BlackIoT/Martinica/node-red/Client/MARTINICA_DEMO/README.md

MARTINICA_DEMO
==============

Demo for Martinica Board

### About

This is your project's README.md file. It helps users understand what your
project does, how to use it and anything else they may need to know.
