BlackIoT/Martinica/Schematics/220321_Martinica_A0_BOM.xlsx

Q.ty | Part Reference | Cod BLK | Description | Mfr | Mfr Part Number | Digi-Key | Mouser
1 | C1 | BLK-000066 | CAP CER 4700PF 50V 10% X7R 0402 | Yageo | CC0402KRX7R9BB472 | 311-1418-1-ND
26 | C2, C9, C10, C12, C13, C14, C18, C19, C20, C21, C22, C23, C25, C26, C28, C31, C32, C33, C45, C46, C47, C48, C49, C50, C54, C56 | BLK-000235 | CAP CER 10PF 50V 5% NP0 0402 | Murata | GRM1555C1H100JA01 | 490-5921-1-ND
2 | C3, C4 | BLK-000065 | CAP CER 20PF 50V 5% NP0 0402 | Yageo | CC0402JRNPO9BN200 | 311-1417-1-ND | 80-CBR04C200J5G
4 | C5, C6, C7, C58 | BLK-000257 | CAP CER 10NF 50V 10% X7R 0402 | Samsung | CL05B103KB5NNNC | 1276-1028-1-ND
11 | C8, C35, C36, C37, C38, C39, C41, C42, C43, C44, C51 | BLK-000258 | CAP CER 100NF 50V 10% X5R 0402 | Murata | GRM155R61H104KE14D | 490-10697-1-ND
2 | C11, C52 | BLK-000073 | CAP CER 1UF 25V 10% X5R 0402 | TDK | C1005X5R1E105K050BE | 445-175215-1-ND
5 | C24, C27, C30, C34, C55 | BLK-000113 | CAP CER 4.7UF 10V 10% X5R 0402 | Samsung | CL05A475KP5NRNC | 1276-1480-1-ND
1 | C29 | BLK-000052 | CAP CER 1NF 50V 10% X7R 0402 | AVX | 04025C102KAT2A | 478-1101-1-ND
3 | C40, C53, C57 | BLK-000255 | CAP CER 10UF 10V 20% X5R 0402 | Samsung | CL05A106MP5NUNC | 1276-1450-1-ND
5 | D1, D2, D3, D4, D5 | BLK-000244 | DIODE SCHOTTKY 30V 800MA USC | Toshiba | CUS08F30,H3F | CUS08F30H3FCT-ND
2 | F1, F2 | BLK-000198 | FUSE PTC RESET 500MA SMD 0603 | Bourns Inc | MF-FSMF050X-2 | MF-FSMF050X-2CT-ND | 652-MFFSMF050X-2
1 | J1 | BLK-000261 | CONN RCPT USB MICRO B R/A SMT | Wurth | 629105136821 | 732-3155-1-ND
1 | J2 | BLK-000260 | CONN 1.27 2X5 SMD SHRD | CnC Tech | 3220-10-0300-00 | 1175-1629-ND
1 | J6 | BLK-000263 | CONN HEADER SMD R/A 3POS 2MM | JST | S3B-PH-SM4-TB(LF)(SN) | 455-1750-1-ND
2 | L1, L2 | BLK-000273 | FERRITE BEAD 120 OHM 0603 1LN | Murata | BLM18AG121SN1D | 490-1011-1-ND
1 | LD1 | BLK-000058 | LED RED 0603 SMD | Wurth | 150060RS75000 | 732-4978-1-ND
1 | LD2 |  | 2121 PLCC4 TRICOLOR | Broadcom | ASMB-LTC2-0A335 | 516-4290-1-ND | 630-ASMB-LTC2-0A335
1 | LD3 | BLK-000059 | LED BRIGHT GREEN 0603 SMD | Wurth | 150060VS75000 | 732-4980-1-ND
1 | LD4 | BLK-000274 | LED GREEN/YELLOW SMD | Wurth | 150066YV54050 | 732-150066YV54050TR-ND
1 | M1 |  | RX TXRX MOD WIFI TRACE ANT SMD | Microchip | ATWINC1500-MR210PB | ATWINC1500-MR210PB-ND
2 | PB1, PB2 | BLK-000239 | SWITCH TACTILE SPST-NO 0.05A 12V PEG | C&K | PTS820 J20KP SMTR LFS | CKN10895CT-ND | 611-PTS820J20KPSMTR
2 | Q1, Q2 |  | SMALL LOW ON RESISTANCE MOSFET | Toshiba | SSM3J358R,LF | SSM3J358RLFCT-ND
8 | R1, R19, R20, R26, R27, R28, R30, R32 | BLK-000276 | RES SMD 1M OHM 1% 1/16W 0402 | Yageo | RC0402FR-071ML | 311-1.00MLRCT-ND
3 | R2, R6, R8 | BLK-000277 | RES SMD 330 OHM 1% 1/16W 0402 | Yageo | RC0402FR-07330RL | 311-330LRCT-ND
3 | R3, R4, R43 | BLK-000100 | RES SMD 1K OHM 1% 1/16W 0402 | Yageo | AC0402FR-071KL | 311-1KLBCT-ND
3 | R5, R7, R47 | BLK-000169 | RES SMD 10K OHM 1% 1/16W 0402 | Yageo | RMCF0402FT10K0 | RMCF0402FT10K0CT-ND
1 | R9 | BLK-000283 | RES 316K OHM 1% 1/16W 0402 | Yageo | RC0402FR-07316KL | YAG3113CT-ND
1 | R10 | BLK-000284 | RES 115K OHM 1% 1/16W 0402 | Yageo | RC0402FR-07115KL | YAG2956CT-ND
24 | R11, R12, R13, R14, R15, R16, R17, R18, R22, R23, R24, R35, R36, R37, R38, R39, R40, R41, R49, R52, R53, R57, R58, R62 | BLK-000159 | RES SMD 0 OHM JUMPER 1/16W 0402 | Yageo | RC0402JR-070RP | YAG1279CT-ND
1 | R25 |  | RES 162 OHM 1% 1/10W 0603 | Yageo | RC0603FR-07162RL | 311-162HRCT-ND
4 | R33, R34, R59, R60 | BLK-000166 | RES SMD 4.7K OHM 1% 1/10W 0603 | Yageo | RC0603FR-074K7L | 311-4.70KHRCT-ND
1 | R44 | BLK-000281 | RES SMD 220 OHM 1% 1/16W 0402 | Yageo | RC0402FR-07220RL | 311-220LRCT-ND
2 | R45, R61 | BLK-000063 | RES SMD 100K OHM 1% 1/16W 0402 | Yageo | RC0402FR-07100KL | 311-100KLRCT-ND
1 | R46 | BLK-000153 | RES SMD 680 OHM 1% 1/16W 0402 | Delta/Cyntec | PFR05S-681-FNH | 2037-PFR05S-681-FNHCT-ND
1 | R48 | BLK-000282 | RES SMD 2.87K OHM 1% 1/10W 0603 | Yageo | RC0603FR-072K87L | 311-2.87KHRCT-ND
1 | R51 | BLK-000162 | RES SMD 10K OHM 1% 1/10W 0603 | Yageo | RC0603FR-0710KL | 311-10.0KHRCT-ND
2 | R54, R55 |  | RES SMD 0 OHM JUMPER 1/10W 0603 | Yageo | RC0603JR-070RL | 311-0.0GRCT-ND | 603-RC0603JR-070RL
1 | R63 |  | RES 422 OHM 1% 1/10W 0603 | Yageo | RC0603FR-07422RL | 311-422HRCT-ND
1 | R64 |  | RES 28 OHM 1% 1/10W 0603 | Yageo | RC0603FR-0728RL | 311-28.0HRCT-ND
3 | TVS1, TVS2, TVS3 | BLK-000286 | TVS DIODE 5.5VWM 12VC DFN1006-2 | Diodes | D5V0F1U2LPQ-7B | 31-D5V0F1U2LPQ-7BCT-ND
1 | U1 | BLK-000265 | IC MCU 32BIT 256KB FLASH 64QFN | Microchip | ATSAMD21J18A-MU | ATSAMD21J18A-MU-ND
1 | U2 |  | IC FLASH 64MBIT SPI/QUAD 8WDFN | Microchip | SST26VF064B-104V/MF | SST26VF064B-104V/MF-ND
1 | U3 | BLK-000266 | Humidity, Pressure, Temperature, VOC Sensor | Bosch | BME688 | 828-BME688CT-ND
1 | U4 |  | IC AUTHENTICATION CHIP 8UDFN | Microchip | ATECC608B-MAHDA-S | 150-ATECC608B-MAHDA-SCT-ND
1 | U5 |  | IC RFID TRANSP 64Kb 13.56MHZ 8UFDFPN | STM | M24SR64-YMC6T/2 | 497-14346-1-ND
1 | U6 |  | IC REG LINEAR 3.3V 500MA 8DFN | Microchip | MCP1725T-3302E/MC | MCP1725T-3302E/MCCT-ND | 579-MCP1725T-3302EMC
1 | U7 |  | IC LI-ION/LI-POLY CTRLR 10DFN | Microchip | MCP73833T-FCI/MF | MCP73833T-FCI/MFCT-ND
1 | Y1 | BLK-000262 | CRYSTAL 32.768KHZ ±20PPM 12.5PF 70KOHM | Abracom | ABS07-32.768KHZ-T | 535-9542-1-ND | 815-ABS07-32.768KHZT
