BlackIoT/Martinica/Schematics/220321_Martinica_A0.pdf

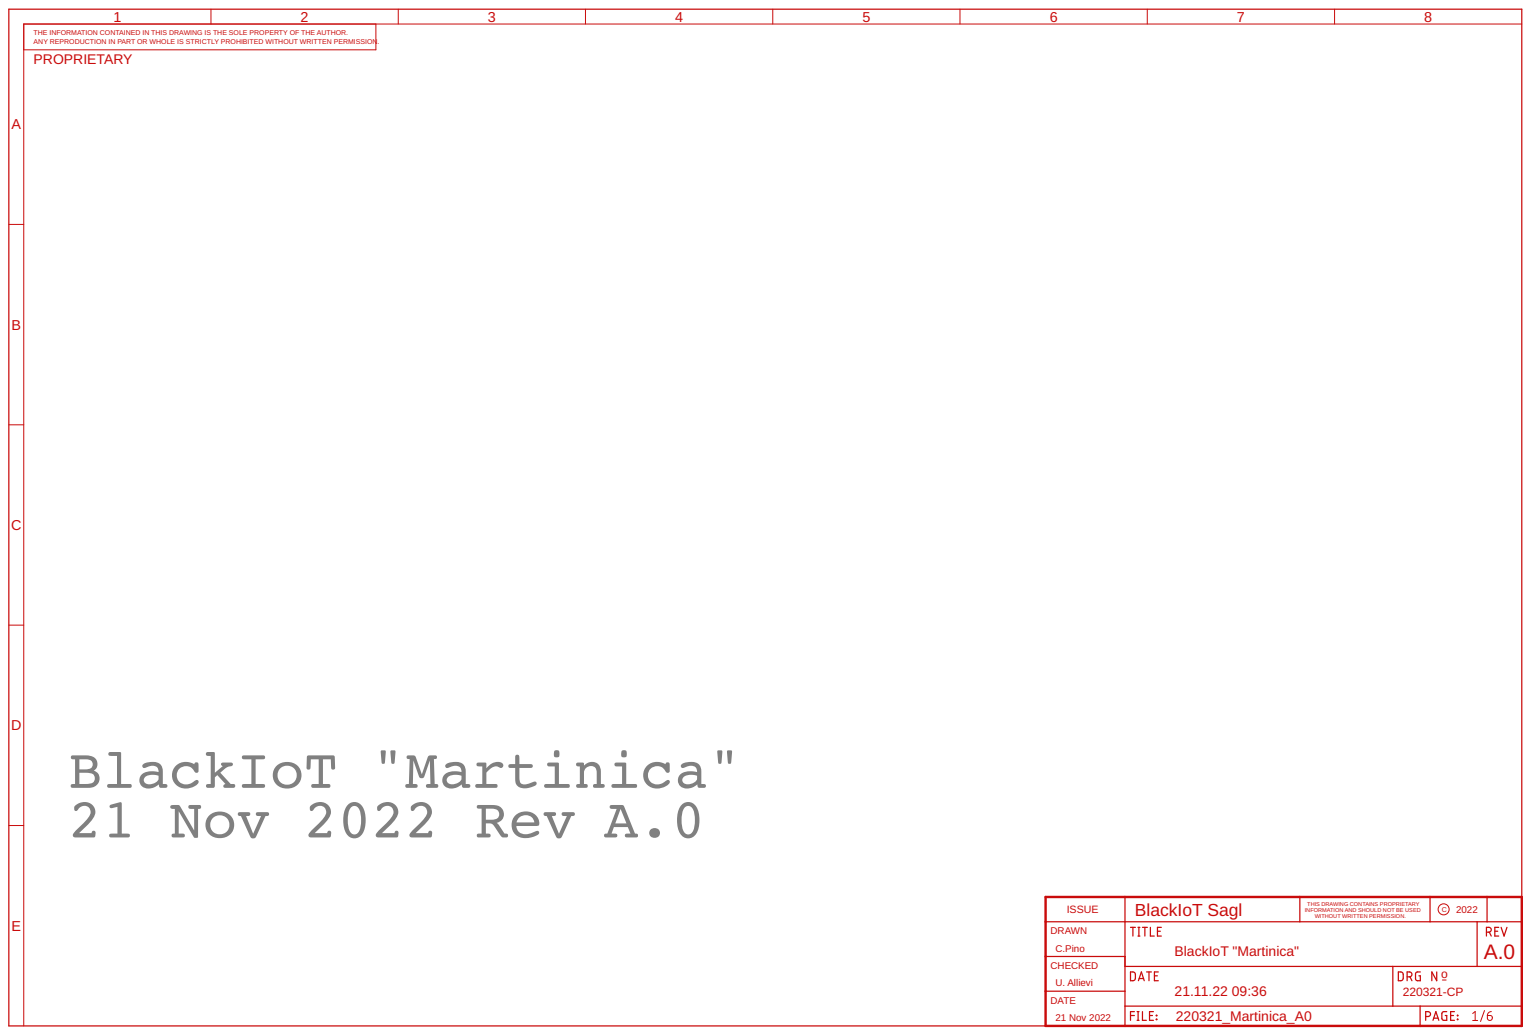
[picture p1: page 1]

THE INFORMATION CONTAINED IN THIS DRAWING IS THE SOLE PROPERTY OF THE AUTHOR. ANY REPRODUCTION IN PART OR WHOLE IS STRICTLY PROHIBITED WITHOUT WRITTEN PERMISSION.

ISSUE | BlackIoT Sagl | THIS DRAWING CONTAINS PROPRIETARY INFORMATION AND SHOULD NOT BE USED WITHOUT WRITTEN PERMISSION. | C 2022

DRAWN | BlackIoT "Martinica" | A.0

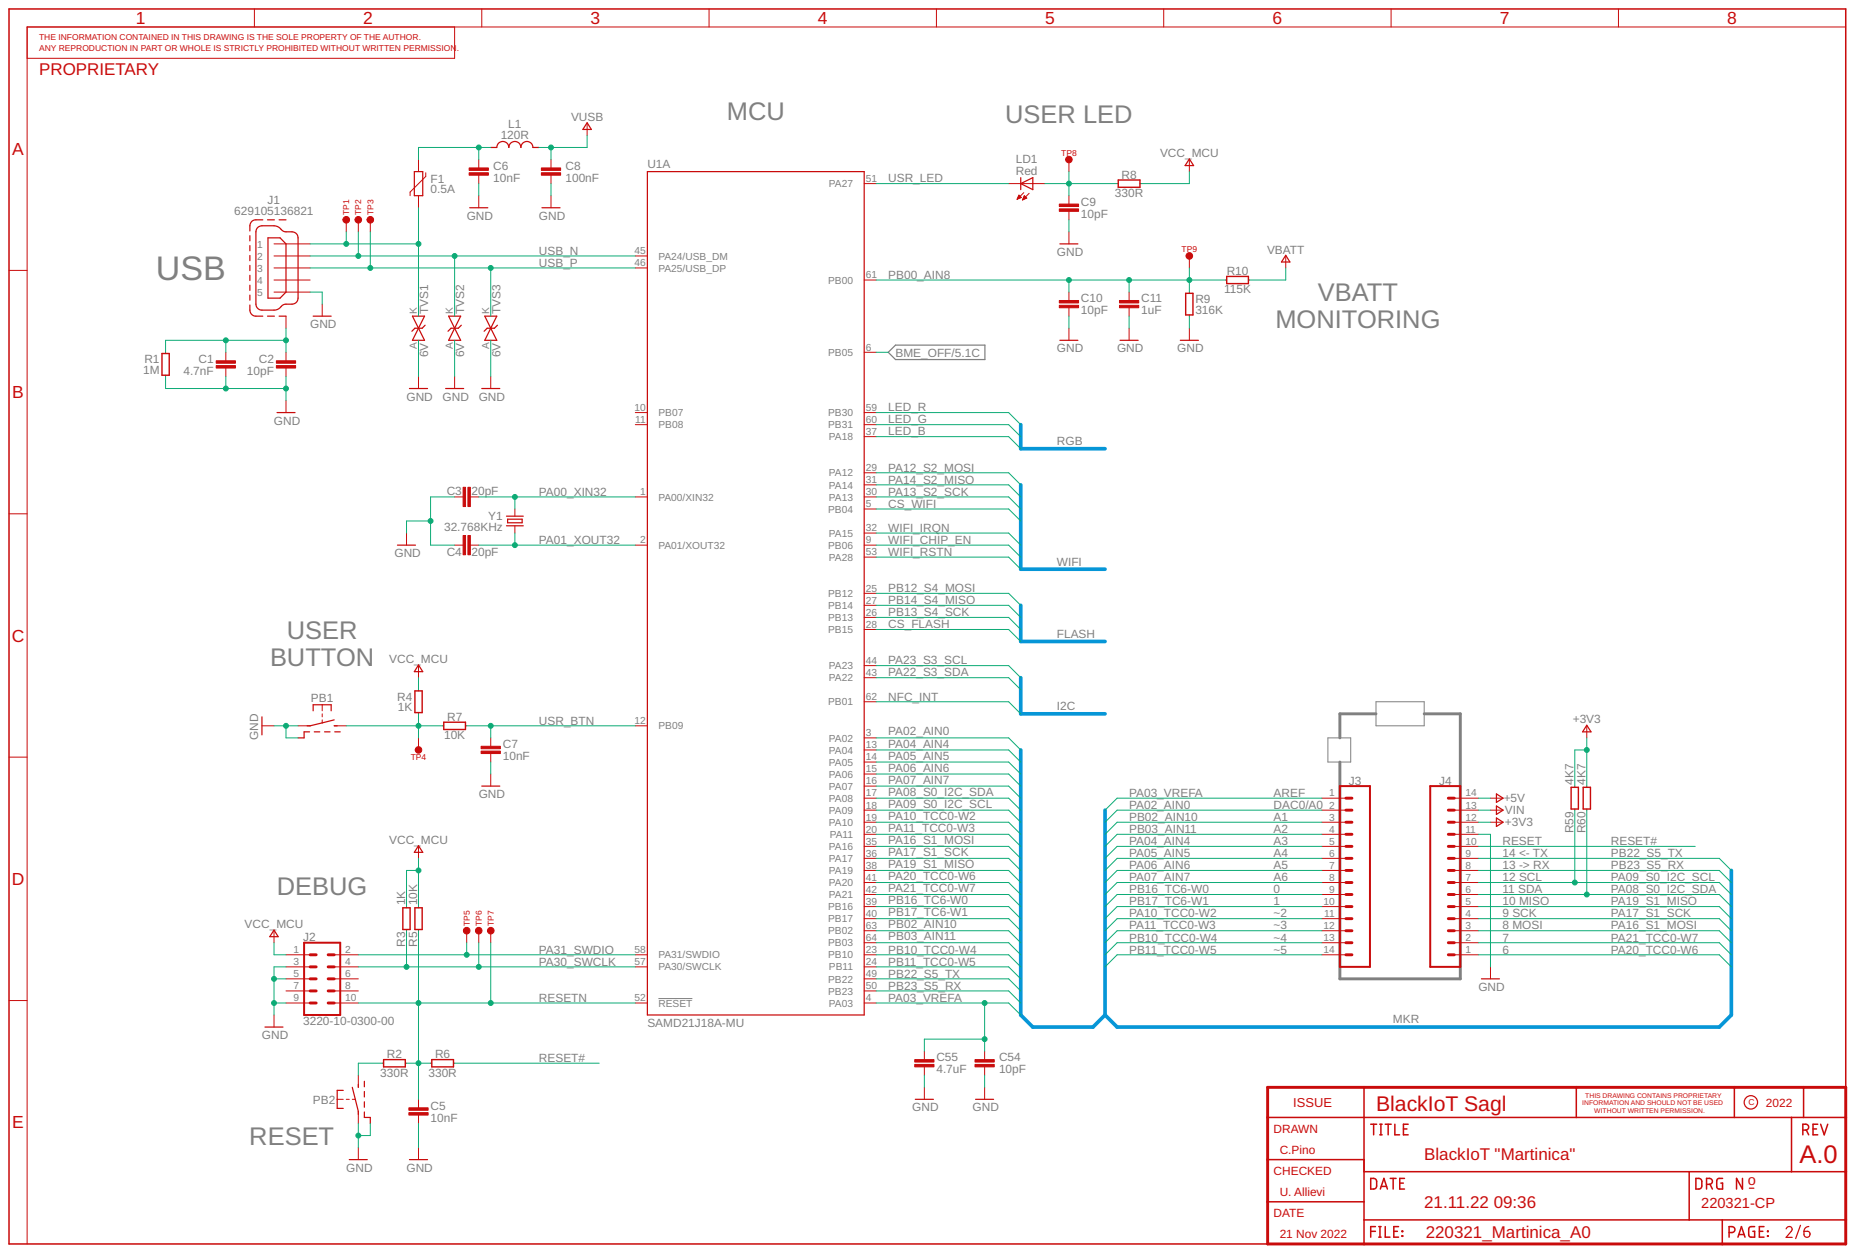
[picture p2: page 2]

PA30_SWCLK

RESETN 52

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

DRAWN | BlackIoT "Martinica" | A.0

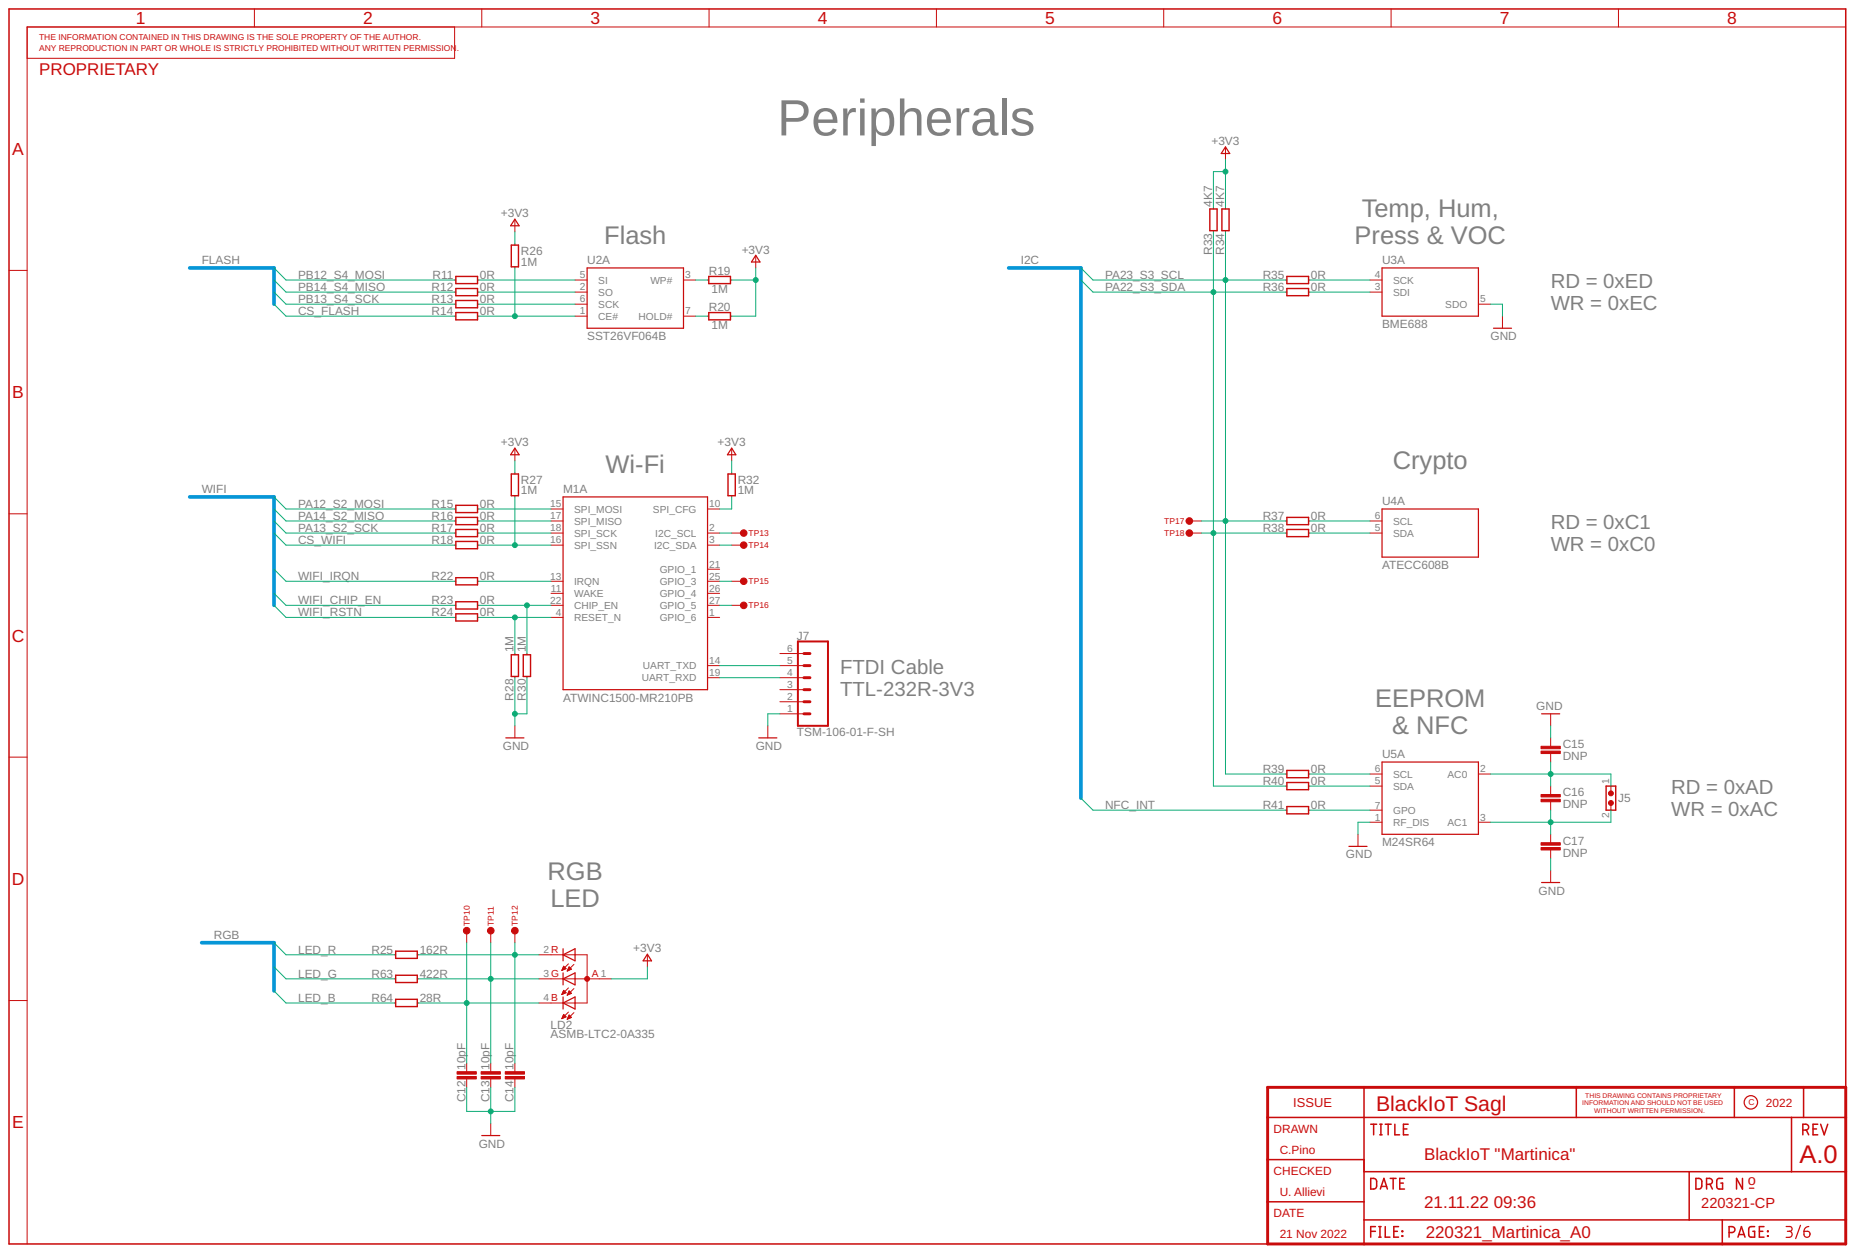
[picture p3: page 3]

Temp, Hum, Press & VOC

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

DRAWN | BlackIoT "Martinica" | A.0

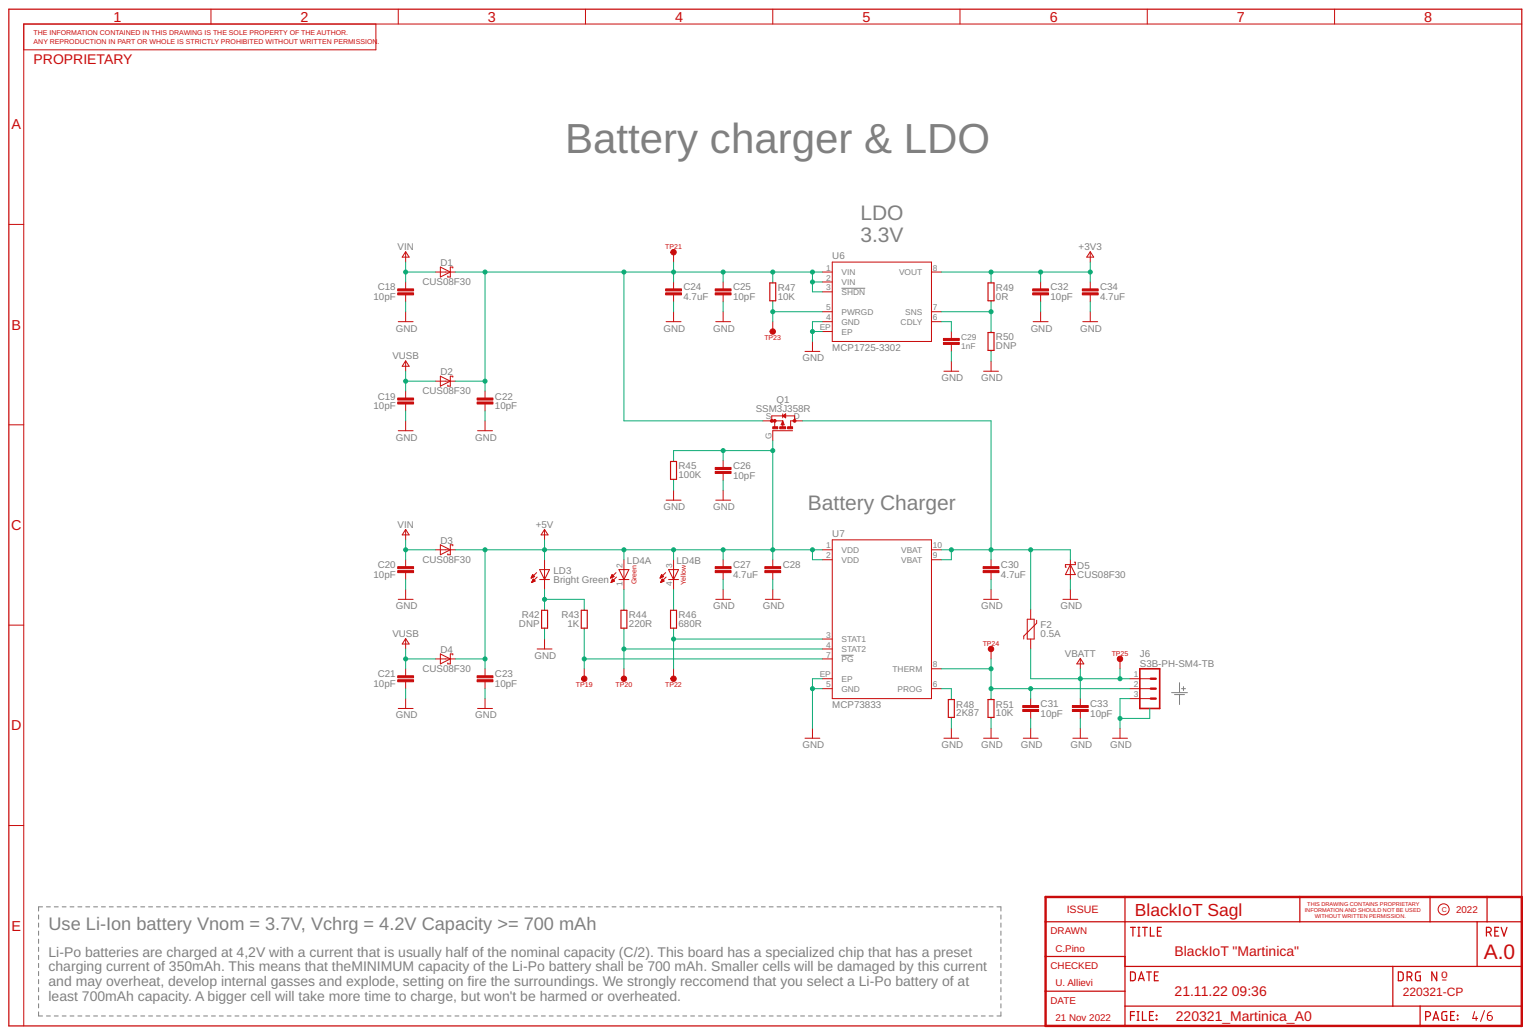
[picture p4: page 4]
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

least 700mAh capacity. A bigger cell will take more time to charge, but won't be harmed or overheated. Use Li-Ion battery Vnom = 3.7V, Vchrg = 4.2V Capacity >= 700 mAh
Li-Po batteries are charged at 4,2V with a current that is usually half of the nominal capacity (C/2). This board has a specialized chip that has a preset
charging current of 350mAh. This means that theMINIMUM capacity of the Li-Po battery shall be 700 mAh. Smaller cells will be damaged by this current
and may overheat, develop internal gasses and explode, setting on fire the surroundings. We strongly reccomend that you select a Li-Po battery of at

DRAWN | BlackIoT "Martinica" | A.0

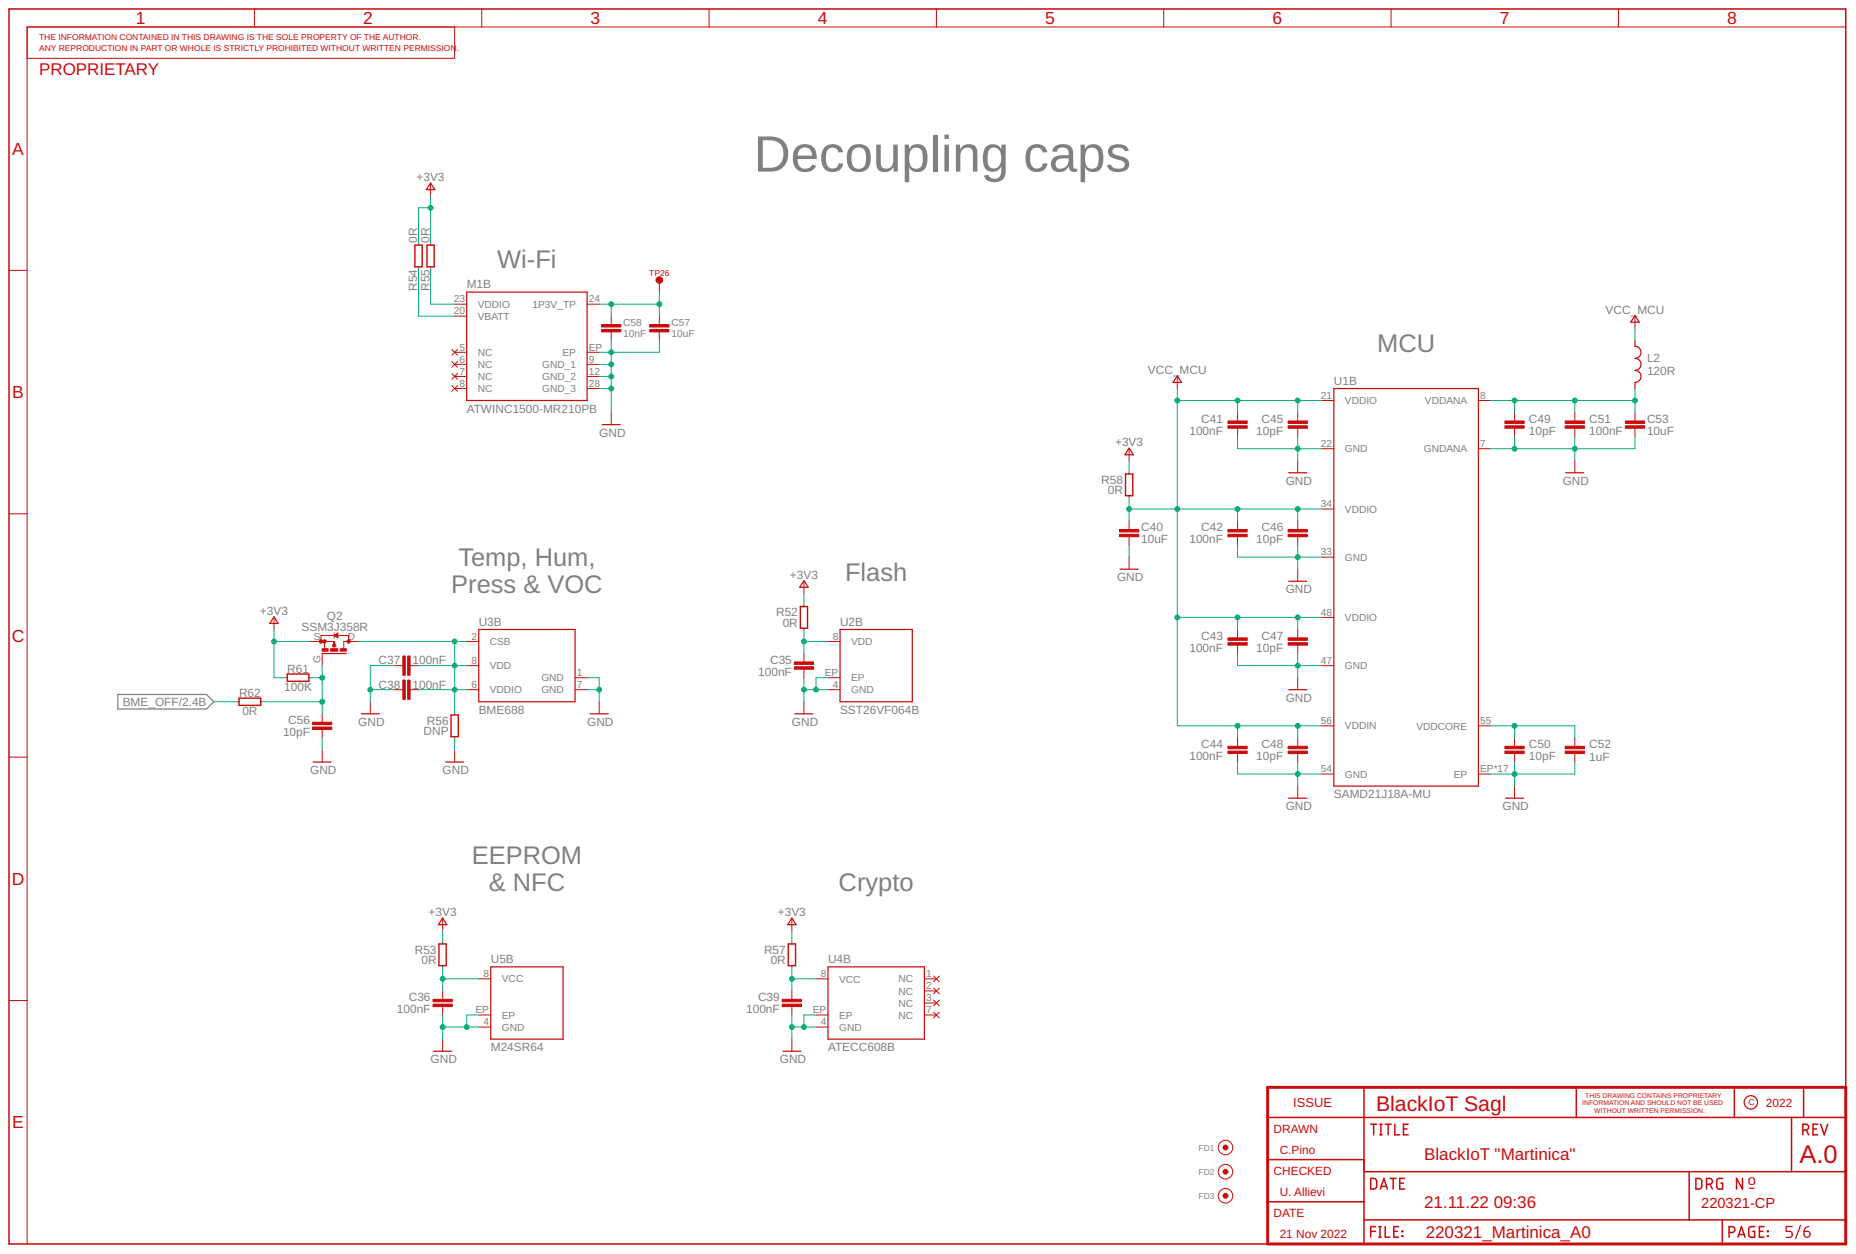
[picture p5: page 5]

Flash Temp, Hum, Press & VOC

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

DRAWN | BlackIoT "Martinica" | A.0

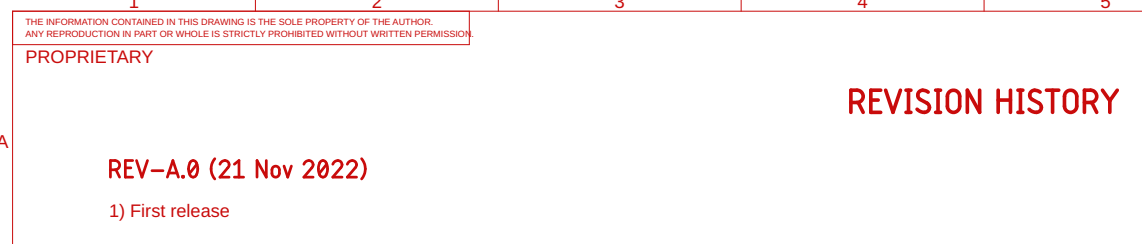
[picture p6: page 6]
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

DRAWN | BlackIoT "Martinica" | A.0
