BlackIoT/Martinica/Schematics/220321_Martinica_A0_ASSY_Bottom.pdf

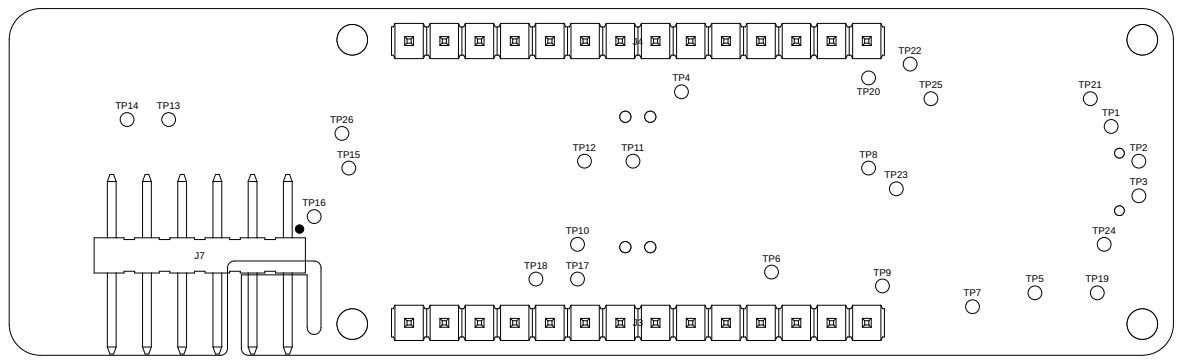
[picture p7: page 1]
