BlackIoT/Martinica/Schematics/220321_Martinica_A0_ASSY_Top.pdf

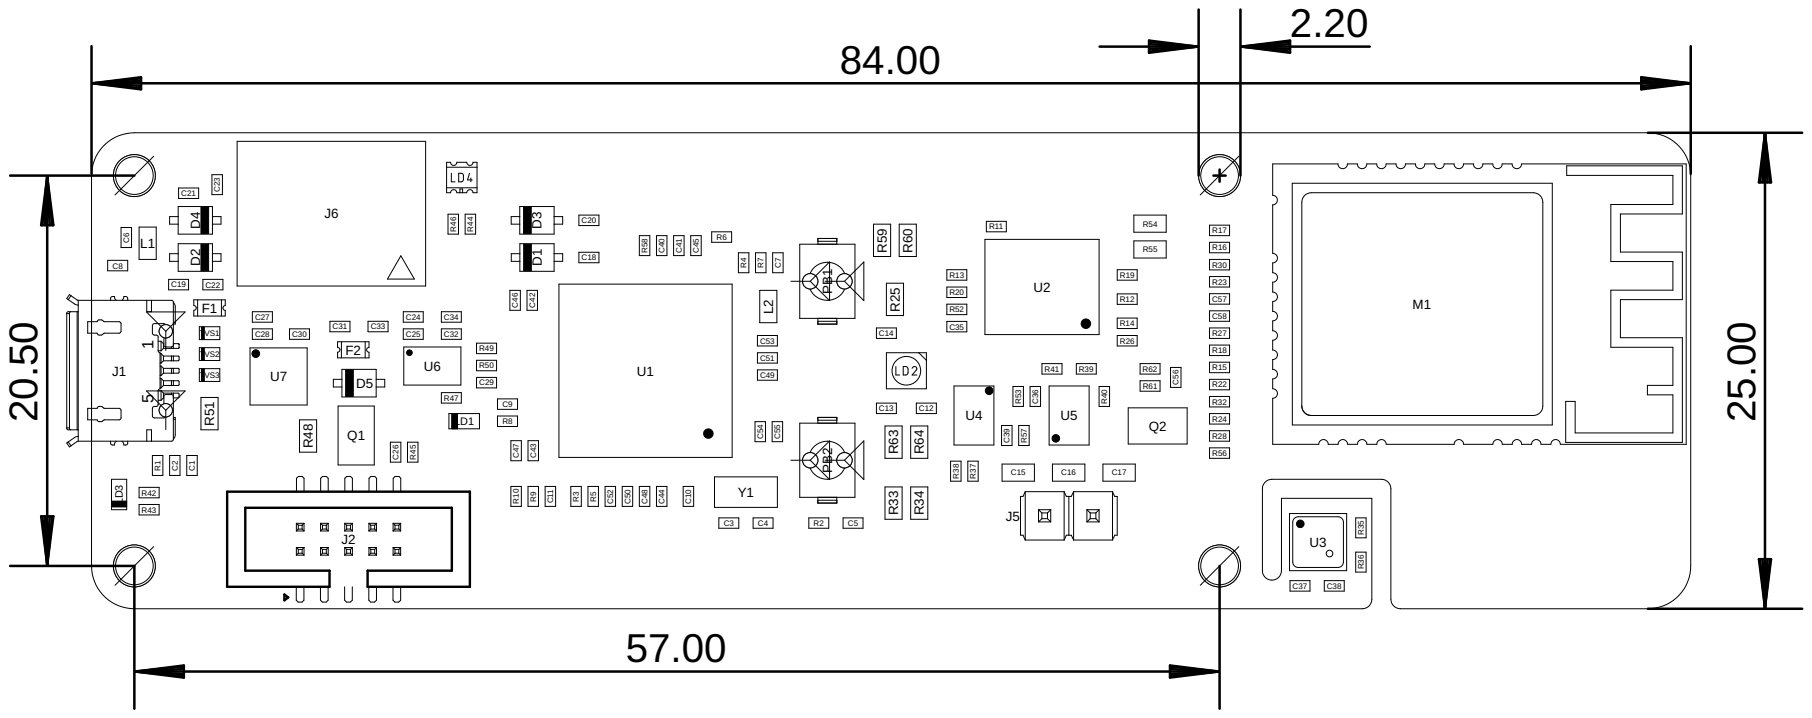
[picture p8: page 1]
