BlackIoT/Martinica/hardware/BlackIoT/samd/variants/martinica/variant.cpp

/*
  Copyright (c) 2014-2015 Arduino LLC.  All right reserved.

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
  You should have received a copy of the GNU Lesser General Public
  License along with this library; if not, write to the Free Software
  Foundation, Inc., 51 Franklin St, Fifth Floor, Boston, MA  02110-1301  USA
*/

#include "variant.h"

const PinDescription g_APinDescription[] = {

/*
 +------------+------------------+--------+-----------------+--------+-----------------------+---------+---------+--------+--------+----------+----------+
 | Pin number |  MKR  Board pin  |  PIN   | Notes           | Peri.A |     Peripheral B      | Perip.C | Perip.D | Peri.E | Peri.F | Periph.G | Periph.H |
 |            |                  |        |                 |   EIC  | ADC |  AC | PTC | DAC | SERCOMx | SERCOMx |  TCCx  |  TCCx  |    COM   | AC/GLCK  |
 |            |                  |        |                 |(EXTINT)|(AIN)|(AIN)|     |     | (x/PAD) | (x/PAD) | (x/WO) | (x/WO) |          |          |
 +------------+------------------+--------+-----------------+--------+-----+-----+-----+-----+---------+---------+--------+--------+----------+----------+
 | 00         | D0               |  PB16  |                 |  *00   |     |     | X04 |     |   5/00  |         |* TC6/0 | TCC0/4 | I2S/SD1  | GCLK_IO2 | // Martinica
 | 01         | D1               |  PB17  |                 |  *01   |     |     | X05 |     |   5/01  |         |* TC6/1 | TCC0/5 | I2S/MCK0 | GCLK_IO3 | // Martinica
 | 02         | D2               |  PA10  |                 |   10   | *18 |     | X02 |     |   0/02  |   2/02  |*TCC1/0 | TCC0/2 | I2S/SCK0 | GCLK_IO4 |
 | 03         | D3               |  PA11  |                 |   11   | *19 |     | X03 |     |   0/03  |   2/03  |*TCC1/1 | TCC0/3 | I2S/FS0  | GCLK_IO5 |
 | 04         | D4               |  PB10  |                 |  *10   |     |     |     |     |         |   4/02  |* TC5/0 | TCC0/4 | I2S/MCK1 | GCLK_IO4 |
 | 05         | D5               |  PB11  |                 |  *11   |     |     |     |     |         |   4/03  |* TC5/1 | TCC0/5 | I2S/SCK1 | GCLK_IO5 |
 | 06         | D6               |  PA20  |                 |  *04   |     |     | X08 |     |   5/02  |   3/02  |  TC7/0 |*TCC0/6 | I2S/SCK0 | GCLK_IO4 |
 | 07         | D7               |  PA21  |                 |  *05   |     |     | X09 |     |   5/03  |   3/03  |  TC7/1 |*TCC0/7 | I2S/FS0  | GCLK_IO5 |
 +------------+------------------+--------+-----------------+--------+-----+-----+-----+-----+---------+---------+--------+--------+----------+----------+
 */
  { PORTB, 16, PIO_DIGITAL, (PIN_ATTR_DIGITAL|PIN_ATTR_PWM|PIN_ATTR_TIMER    ), No_ADC_Channel, PWM6_CH0,   TC6_CH0,      EXTERNAL_INT_0    },
  { PORTB, 17, PIO_DIGITAL, (PIN_ATTR_DIGITAL|PIN_ATTR_PWM|PIN_ATTR_TIMER    ), No_ADC_Channel, PWM6_CH1,   TC6_CH1,      EXTERNAL_INT_1    },
  { PORTA, 10, PIO_DIGITAL, (PIN_ATTR_DIGITAL|PIN_ATTR_PWM|PIN_ATTR_TIMER    ), ADC_Channel18,  PWM1_CH0,   TCC1_CH0,     EXTERNAL_INT_NONE },
  { PORTA, 11, PIO_DIGITAL, (PIN_ATTR_DIGITAL|PIN_ATTR_PWM|PIN_ATTR_TIMER    ), ADC_Channel19,  PWM1_CH1,   TCC1_CH1,     EXTERNAL_INT_NONE },
  { PORTB, 10, PIO_DIGITAL, (PIN_ATTR_DIGITAL|PIN_ATTR_PWM|PIN_ATTR_TIMER    ), No_ADC_Channel, PWM5_CH0,   TC5_CH0,      EXTERNAL_INT_10   },
  { PORTB, 11, PIO_DIGITAL, (PIN_ATTR_DIGITAL|PIN_ATTR_PWM|PIN_ATTR_TIMER    ), No_ADC_Channel, PWM5_CH1,   TC5_CH1,      EXTERNAL_INT_11   },
  { PORTA, 20, PIO_DIGITAL, (PIN_ATTR_DIGITAL|PIN_ATTR_PWM|PIN_ATTR_TIMER_ALT), No_ADC_Channel, PWM0_CH6,   TCC0_CH6,     EXTERNAL_INT_4    },
  { PORTA, 21, PIO_DIGITAL, (PIN_ATTR_DIGITAL|PIN_ATTR_PWM|PIN_ATTR_TIMER_ALT), No_ADC_Channel, PWM0_CH7,   TCC0_CH7,     EXTERNAL_INT_5    },

/*
 +------------+------------------+--------+-----------------+--------+-----------------------+---------+---------+--------+--------+----------+----------+
 | Pin number |  MKR  Board pin  |  PIN   | Notes           | Peri.A |     Peripheral B      | Perip.C | Perip.D | Peri.E | Peri.F | Periph.G | Periph.H |
 |            |                  |        |                 |   EIC  | ADC |  AC | PTC | DAC | SERCOMx | SERCOMx |  TCCx  |  TCCx  |    COM   | AC/GLCK  |
 |            |                  |        |                 |(EXTINT)|(AIN)|(AIN)|     |     | (x/PAD) | (x/PAD) | (x/WO) | (x/WO) |          |          |
 +------------+------------------+--------+-----------------+--------+-----+-----+-----+-----+---------+---------+--------+--------+----------+----------+
 |            |       SPI        |        |                 |        |     |     |     |     |         |         |        |        |          |          |
 | 08         | MOSI             |  PA16  |                 |  *00   |     |     | X04 |     |  *1/00  |   3/00  |*TCC2/0 | TCC0/6 |          | GCLK_IO2 |
 | 09         | SCK              |  PA17  |                 |  *01   |     |     | X05 |     |  *1/01  |   3/01  | TCC2/1 | TCC0/7 |          | GCLK_IO3 |
 | 10         | MISO             |  PA19  |                 |   03   |     |     | X07 |     |  *1/03  |   3/03  |* TC3/1 | TCC0/3 | I2S/SD0  | AC/CMP1  |
 +------------+------------------+--------+-----------------+--------------------+-----+-----+---------+---------+--------+--------+----------+----------+
 |            |       Wire       |        |                 |        |     |     |     |     |         |         |        |        |          |          |
 | 11         | SDA              |  PA08  |                 |   NMI  | *16 |     | X00 |     |  *0/00  |   2/00  | TCC0/0 | TCC1/2 | I2S/SD1  |          |
 | 12         | SCL              |  PA09  |                 |   09   | *17 |     | X01 |     |  *0/01  |   2/01  | TCC0/1 | TCC1/3 | I2S/MCK0 |          |
 +------------+------------------+--------+-----------------+--------+-----+-----+-----+-----+---------+---------+--------+--------+----------+----------+
 |            |      Serial1     |        |                 |        |     |     |     |     |         |         |        |        |          |          |
 | 13         | RX               |  PB23  |                 |   07   |     |     |     |     |         |  *5/03  |  TC7/1 | TCC3/1 |          | GCLK_IO1 |
 | 14         | TX               |  PB22  |                 |   06   |     |     |     |     |         |  *5/02  |  TC7/0 | TCC3/0 |          | GCLK_IO0 |
 +------------+------------------+--------+-----------------+--------+-----+-----+-----+-----+---------+---------+--------+--------+----------+----------+
 */
                                                                                                                                               // DIPO=3 DOPO=0
  { PORTA, 16, PIO_SERCOM,  (PIN_ATTR_DIGITAL|PIN_ATTR_PWM|PIN_ATTR_TIMER    ), No_ADC_Channel, PWM2_CH0,   TCC2_CH0,     EXTERNAL_INT_0    }, // MOSI: SERCOM1/PAD[0]
  { PORTA, 17, PIO_SERCOM,  (PIN_ATTR_DIGITAL                                ), No_ADC_Channel, NOT_ON_PWM, NOT_ON_TIMER, EXTERNAL_INT_1    }, // SCK:  SERCOM1/PAD[1]
  { PORTA, 19, PIO_SERCOM,  (PIN_ATTR_DIGITAL|PIN_ATTR_PWM|PIN_ATTR_TIMER    ), No_ADC_Channel, PWM3_CH1,   TC3_CH1,      EXTERNAL_INT_NONE }, // MISO: SERCOM1/PAD[3]

                                                                                                                                               // PINOUT=0
  { PORTA,  8, PIO_SERCOM,     (PIN_ATTR_DIGITAL                             ), ADC_Channel16,  NOT_ON_PWM, NOT_ON_TIMER, EXTERNAL_INT_NMI  }, // SDA:  SERCOM0/PAD[0]
  { PORTA,  9, PIO_SERCOM,     (PIN_ATTR_DIGITAL                             ), ADC_Channel17,  NOT_ON_PWM, NOT_ON_TIMER, EXTERNAL_INT_NONE }, // SCL:  SERCOM0/PAD[1]

                                                                                                                                               // RXPO=3 TXPO=1
  { PORTB, 23, PIO_SERCOM_ALT, (PIN_ATTR_DIGITAL                             ), No_ADC_Channel, NOT_ON_PWM, NOT_ON_TIMER, EXTERNAL_INT_NONE }, // RX:   SERCOM5/PAD[3]
  { PORTB, 22, PIO_SERCOM_ALT, (PIN_ATTR_DIGITAL                             ), No_ADC_Channel, NOT_ON_PWM, NOT_ON_TIMER, EXTERNAL_INT_NONE }, // TX:   SERCOM5/PAD[2]


/*
 +------------+------------------+--------+-----------------+--------+-----------------------+---------+---------+--------+--------+----------+----------+
 | Pin number |  MKR  Board pin  |  PIN   | Notes           | Peri.A |     Peripheral B      | Perip.C | Perip.D | Peri.E | Peri.F | Periph.G | Periph.H |
 |            |                  |        |                 |   EIC  | ADC |  AC | PTC | DAC | SERCOMx | SERCOMx |  TCCx  |  TCCx  |    COM   | AC/GLCK  |
 |            |                  |        |                 |(EXTINT)|(AIN)|(AIN)|     |     | (x/PAD) | (x/PAD) | (x/WO) | (x/WO) |          |          |
 +------------+------------------+--------+-----------------+--------+-----+-----+-----+-----+---------+---------+--------+--------+----------+----------+
 | 15         | A0 / DAC0        |  PA02  |                 |   02   | *00 |     | Y00 | OUT |         |         |        | TCC3/0 |          |          |
 | 16         | A1               |  PB02  |                 |  *02   | *10 |     | Y08 |     |         |   5/00  |  TC6/0 | TCC3/2 |          |          |
 | 17         | A2               |  PB03  |                 |  *03   | *11 |     | Y09 |     |         |   5/01  |  TC6/1 | TCC3/3 |          |          |
 | 18         | A3               |  PA04  |                 |   04   | *04 |  00 | Y02 |     |         |   0/00  |*TCC0/0 | TCC3/2 |          |          |
 | 19         | A4               |  PA05  |                 |   05   | *05 |  01 | Y03 |     |         |   0/01  |*TCC0/1 | TCC3/3 |          |          |
 | 20         | A5               |  PA06  |                 |   06   | *06 |  02 | Y04 |     |         |   0/02  | TCC1/0 | TCC3/4 |          |          |
 | 21         | A6               |  PA07  |                 |   07   | *07 |  03 | Y05 |     |         |   0/03  | TCC1/1 | TCC3/5 | I2S/SD0  |          |
 +------------+------------------+--------+-----------------+--------+-----+-----+-----+-----+---------+---------+--------+--------+----------+----------+
 */
  { PORTA,  2, PIO_ANALOG,  (PIN_ATTR_DIGITAL|PIN_ATTR_ANALOG /*DAC*/        ), ADC_Channel0,   NOT_ON_PWM, NOT_ON_TIMER, EXTERNAL_INT_NONE },
  { PORTB,  2, PIO_ANALOG,  (PIN_ATTR_DIGITAL                                ), ADC_Channel10,  NOT_ON_PWM, NOT_ON_TIMER, EXTERNAL_INT_2    },
  { PORTB,  3, PIO_ANALOG,  (PIN_ATTR_DIGITAL                                ), ADC_Channel11,  NOT_ON_PWM, NOT_ON_TIMER, EXTERNAL_INT_3    },
  { PORTA,  4, PIO_ANALOG,  (PIN_ATTR_DIGITAL|PIN_ATTR_PWM|PIN_ATTR_TIMER    ), ADC_Channel4,   PWM0_CH0,   TCC0_CH0,     EXTERNAL_INT_NONE },
  { PORTA,  5, PIO_ANALOG,  (PIN_ATTR_DIGITAL|PIN_ATTR_PWM|PIN_ATTR_TIMER    ), ADC_Channel5,   PWM0_CH1,   TCC0_CH1,     EXTERNAL_INT_NONE },
  { PORTA,  6, PIO_ANALOG,  (PIN_ATTR_DIGITAL                                ), ADC_Channel6,   NOT_ON_PWM, NOT_ON_TIMER, EXTERNAL_INT_NONE },
  { PORTA,  7, PIO_ANALOG,  (PIN_ATTR_DIGITAL                                ), ADC_Channel7,   NOT_ON_PWM, NOT_ON_TIMER, EXTERNAL_INT_NONE },

/*
 +------------+------------------+--------+-----------------+--------+-----------------------+---------+---------+--------+--------+----------+----------+
 | Pin number |  MKR  Board pin  |  PIN   | Notes           | Peri.A |     Peripheral B      | Perip.C | Perip.D | Peri.E | Peri.F | Periph.G | Periph.H |
 |            |                  |        |                 |   EIC  | ADC |  AC | PTC | DAC | SERCOMx | SERCOMx |  TCCx  |  TCCx  |    COM   | AC/GLCK  |
 |            |                  |        |                 |(EXTINT)|(AIN)|(AIN)|     |     | (x/PAD) | (x/PAD) | (x/WO) | (x/WO) |          |          |
 +------------+------------------+--------+-----------------+--------+-----+-----+-----+-----+---------+---------+--------+--------+----------+----------+
 |            |       USB        |        |                 |        |     |     |     |     |         |         |        |        |          |          |
 | 22         |                  |  PA24  | USB N           |   12   |     |     |     |     |   3/02  |   5/02  |  TC5/0 | TCC1/2 | USB/DM   |          |
 | 23         |                  |  PA25  | USB P           |   13   |     |     |     |     |   3/03  |   5/03  |  TC5/1 | TCC1/3 | USB/DP   |          |
 | 24         |                  |  PA18  | LED_B           |   02   |     |     | X06 |     |   1/02  |   3/02  |  TC3/0 | TCC0/2 |          | AC/CMP0  | // Martinica
 +------------+------------------+--------+-----------------+--------+-----+-----+-----+-----+---------+---------+--------+--------+----------+----------+
 | 25         | AREF             |  PA03  |                 |   03   |  01 |     | Y01 |     |         |         |        | TCC3/1 |          |          |
 +------------+------------------+--------+-----------------+--------+-----+-----+-----+-----+---------+---------+--------+--------+----------+----------+
 */
  { PORTA, 24, PIO_COM,     (PIN_ATTR_NONE                                   ), No_ADC_Channel, NOT_ON_PWM, NOT_ON_TIMER, EXTERNAL_INT_NONE }, // USB/DM
  { PORTA, 25, PIO_COM,     (PIN_ATTR_NONE                                   ), No_ADC_Channel, NOT_ON_PWM, NOT_ON_TIMER, EXTERNAL_INT_NONE }, // USB/DP
  { PORTA, 18, PIO_DIGITAL, (PIN_ATTR_DIGITAL|PIN_ATTR_PWM|PIN_ATTR_TIMER    ), No_ADC_Channel, PWM3_CH0, TC3_CH0, EXTERNAL_INT_NONE },

  { PORTA,  3, PIO_DIGITAL, (PIN_ATTR_DIGITAL                                ), No_ADC_Channel, NOT_ON_PWM, NOT_ON_TIMER, EXTERNAL_INT_NONE }, // DAC/VREFP

/*
 +------------+------------------+--------+-----------------+--------+-----------------------+---------+---------+--------+--------+----------+----------+
 | Pin number |  MKR  Board pin  |  PIN   | Notes           | Peri.A |     Peripheral B      | Perip.C | Perip.D | Peri.E | Peri.F | Periph.G | Periph.H |
 |            |                  |        |                 |   EIC  | ADC |  AC | PTC | DAC | SERCOMx | SERCOMx |  TCCx  |  TCCx  |    COM   | AC/GLCK  |
 |            |                  |        |                 |(EXTINT)|(AIN)|(AIN)|     |     | (x/PAD) | (x/PAD) | (x/WO) | (x/WO) |          |          |
 +------------+------------------+--------+-----------------+--------+-----+-----+-----+-----+---------+---------+--------+--------+----------+----------+
 |            | WiFi SPI         |        |                 |        |     |     |     |     |         |         |        |        |          |          |
 | 26         |                  |  PA12  | WiFi MOSI       |   12   |     |     |     |     |  *2/00  |   4/00  | TCC2/0 | TCC0/6 |          | AC/CMP0  | // Martinica
 | 27         |                  |  PA13  | WiFi SCK        |   13   |     |     |     |     |  *2/01  |   4/01  | TCC2/1 | TCC0/7 |          | AC/CMP1  | // Martinica
 | 28         |                  |  PA14  | WiFi MISO       |   14   |     |     |     |     |  *2/02  |   4/02  |  TC3/0 | TCC0/4 |          | GCLK_IO0 | // Martinica
 | 29         |                  |  PA15  | WiFi IRQn       |   15   |     |     |     |     |  *2/03  |   4/03  |  TC3/1 | TCC0/5 |          | GCLK_IO1 | // Martinica
 | 30         |                  |  PB04  | WiFi CS         |   04   | 12  |  Y0 |     |     |         |         |        |        |          |          | // Martinica
 | 31         |                  |  PB06  | WiFi EN         |   06   | 14  |     |  12 |     |         |         |        |        |          |          | // Martinica 
 | 32         |                  |  PA28  | WiFi RSTn       |   08   |     |     |     |     |         |         |        | TCC3/7 |          | GCLK_IO0 | // Martinica
 +------------+------------------+--------+-----------------+--------+-----+-----+-----+-----+---------+---------+--------+--------+----------+----------+
*/

  { PORTA, 12, PIO_SERCOM,     (PIN_ATTR_NONE                                ), No_ADC_Channel, NOT_ON_PWM, NOT_ON_TIMER, EXTERNAL_INT_NONE }, // MOSI: SERCOM2/PAD[0]
  { PORTA, 13, PIO_SERCOM,     (PIN_ATTR_NONE                                ), No_ADC_Channel, NOT_ON_PWM, NOT_ON_TIMER, EXTERNAL_INT_NONE }, // SCK:  SERCOM2/PAD[1]
  { PORTA, 14, PIO_SERCOM,     (PIN_ATTR_NONE                                ), No_ADC_Channel, NOT_ON_PWM, NOT_ON_TIMER, EXTERNAL_INT_NONE }, // MISO: SERCOM2/PAD[2] 
  { PORTA, 15, PIO_DIGITAL,    (PIN_ATTR_DIGITAL                             ), No_ADC_Channel, NOT_ON_PWM, NOT_ON_TIMER, EXTERNAL_INT_15   }, 
  { PORTB,  4, PIO_DIGITAL,    (PIN_ATTR_DIGITAL                             ), No_ADC_Channel, NOT_ON_PWM, NOT_ON_TIMER, EXTERNAL_INT_NONE }, // SS:   as GPIO
  { PORTB,  6, PIO_DIGITAL,    (PIN_ATTR_DIGITAL                             ), No_ADC_Channel, NOT_ON_PWM, NOT_ON_TIMER, EXTERNAL_INT_NONE },
  { PORTA, 28, PIO_DIGITAL,    (PIN_ATTR_DIGITAL                             ), No_ADC_Channel, NOT_ON_PWM, NOT_ON_TIMER, EXTERNAL_INT_NONE },
    
/* 
 +------------+------------------+--------+-----------------+--------+-----------------------+---------+---------+--------+--------+----------+----------+
 | Pin number |  MKR  Board pin  |  PIN   | Notes           | Peri.A |     Peripheral B      | Perip.C | Perip.D | Peri.E | Peri.F | Periph.G | Periph.H |
 |            |                  |        |                 |   EIC  | ADC |  AC | PTC | DAC | SERCOMx | SERCOMx |  TCCx  |  TCCx  |    COM   | AC/GLCK  |
 |            |                  |        |                 |(EXTINT)|(AIN)|(AIN)|     |     | (x/PAD) | (x/PAD) | (x/WO) | (x/WO) |          |          |
 +------------+------------------+--------+-----------------+--------+-----+-----+-----+-----+---------+---------+--------+--------+----------+----------+
 | 33         |                  |  PA27  | LED_BUILTIN     |   15   |     |     |     |     |         |         |        | TCC3/6 |          | GCLK_IO0 | // Martinica
 +------------+------------------+--------+-----------------+--------+-----+-----+-----+-----+---------+---------+--------+--------+----------+----------+
 |            | FLASH SPI        |        |                 |        |     |     |     |     |         |         |        |        |          |          |
 | 34         |                  |  PB12  | FLASH MOSI      |   12   |     |     | X12 |     |  *4/00  |         |  TC4/0 | TCC0/6 |          | GCLK_IO6 | // Martinica
 | 35         |                  |  PB13  | FLASH SCK       |   13   |     |     | X13 |     |  *4/01  |         |  TC4/1 | TCC0/7 |          | GCLK_IO7 | // Martinica
 | 36         |                  |  PB14  | FLASH MISO      |   14   |     |     | X14 |     |  *4/02  |         |  TC5/0 |        |          | GCLK_IO0 | // Martinica
 | 37         |                  |  PB15  | FLASH CS        |   15   |     |     | X15 |     |  *4/03  |         |  TC5/1 |        |          | GCLK_IO1 | // Martinica
 +------------+------------------+--------+-----------------+--------------------+-----+-----+---------+---------+--------+--------+----------+----------+
 | 38         |                  |  PB30  | LED_R           |   14   |     |     |     |     |         |   5/00  | TCC0/0 | TCC1/2 |          |          | // Martinica
 | 39         |                  |  PB31  | LED_G           |   15   |     |     |     |     |         |   5/01  | TCC0/1 | TCC1/3 |          |          | // Martinica
 | 40         |                  |  PB00  | ADC_BATTERY     |  *00   |  08 |     | Y06 |     |         |   5/02  |  TC7/0 |        |          |          | // Martinica
 +------------+------------------+--------+-----------------+--------------------+-----+-----+---------+---------+--------+--------+----------+----------+
 |            |       Wire       |        |                 |        |     |     |     |     |         |         |        |        |          |          |
 | 41         | SDA              |  PA22  | SNS_SDA         |   06   |     |     | X10 |     |  *3/00  |   5/00  |  TC4/0 | TCC0/4 |          | GCLK_IO6 | // Martinica
 | 42         | SCL              |  PA23  | SNS_SCL         |   07   |     |     | X11 |     |  *3/01  |   5/01  |  TC4/1 | TCC0/5 |          | GCLK_IO7 | // Martinica
 | 43         |                  |  PB01  | NFC_INT         |   01   |  09 |     | Y07 |     |         |   5/03  |  TC7/1 |        |          |          | // Martinica
 +------------+------------------+--------+-----------------+--------+-----+-----+-----+-----+---------+---------+--------+--------+----------+----------+
 | 44         |                  |  PB09  | USER_BUTTON     |   09   |  03 |     |     |     |         |   4/01  |  TC4/1 | TCC3/7 |          |          | // Martinica
 | 45         |                  |  PB05  | BME_OFF         |   05   |  13 |     | X11 |     |         |         |        |        |          |          | // Martinica 
 +------------+------------------+--------+-----------------+--------+-----+-----+-----+-----+---------+---------+--------+--------+----------+----------+
 |            | 32768Hz Crystal  |        |                 |        |     |     |     |     |         |         |        |        |          |          |
 | 46         |                  |  PA00  | XIN32           |   00   |     |     |     |     |         |   1/00  | TCC2/0 |        |          |          |
 | 47         |                  |  PA01  | XOUT32          |   01   |     |     |     |     |         |   1/01  | TCC2/1 |        |          |          |
 +------------+------------------+--------+-----------------+--------+-----+-----+-----+-----+---------+---------+--------+--------+----------+----------+
 */
                                                                                                                                             
//  { PORTA, 27, PIO_DIGITAL,    (PIN_ATTR_DIGITAL|PIN_ATTR_PWM|PIN_ATTR_TIMER_ALT ), No_ADC_Channel, PWM3_CH6,   TCC3_CH6,     EXTERNAL_INT_NONE },
  { PORTA, 27, PIO_DIGITAL,    (PIN_ATTR_DIGITAL                             ), No_ADC_Channel, NOT_ON_PWM, NOT_ON_TIMER, EXTERNAL_INT_NONE },
                                                                                                                                               // DIPO=3 DOPO=0
  { PORTB, 12, PIO_SERCOM,     (PIN_ATTR_NONE                                ), No_ADC_Channel, NOT_ON_PWM, NOT_ON_TIMER, EXTERNAL_INT_NONE }, // MOSI: SERCOM4/PAD[0]
  { PORTB, 13, PIO_SERCOM,     (PIN_ATTR_NONE                                ), No_ADC_Channel, NOT_ON_PWM, NOT_ON_TIMER, EXTERNAL_INT_NONE }, // SCK:  SERCOM4/PAD[1]
  { PORTB, 14, PIO_SERCOM,     (PIN_ATTR_NONE                                ), No_ADC_Channel, NOT_ON_PWM, NOT_ON_TIMER, EXTERNAL_INT_NONE }, // MISO: SERCOM4/PAD[2] 
  { PORTB, 15, PIO_DIGITAL,    (PIN_ATTR_DIGITAL                             ), No_ADC_Channel, NOT_ON_PWM, NOT_ON_TIMER, EXTERNAL_INT_NONE }, // SS:   as GPIO
  
  { PORTB, 30, PIO_DIGITAL,    (PIN_ATTR_DIGITAL|PIN_ATTR_PWM|PIN_ATTR_TIMER_ALT), No_ADC_Channel, PWM1_CH2, TCC1_CH2, EXTERNAL_INT_NONE },
  { PORTB, 31, PIO_DIGITAL,    (PIN_ATTR_DIGITAL|PIN_ATTR_PWM|PIN_ATTR_TIMER_ALT), No_ADC_Channel, PWM1_CH3, TCC1_CH3, EXTERNAL_INT_NONE },
  { PORTB, 00, PIO_ANALOG,     (PIN_ATTR_NONE                                ), ADC_Channel8,   NOT_ON_PWM, NOT_ON_TIMER, EXTERNAL_INT_NONE }, 
                                                                                                                                               // PINOUT=0
  { PORTA, 22, PIO_SERCOM,     (PIN_ATTR_DIGITAL                             ), No_ADC_Channel,  NOT_ON_PWM, NOT_ON_TIMER, EXTERNAL_INT_6    }, // SDA:  SERCOM3/PAD[0]
  { PORTA, 23, PIO_SERCOM,     (PIN_ATTR_DIGITAL                             ), No_ADC_Channel,  NOT_ON_PWM, NOT_ON_TIMER, EXTERNAL_INT_7    }, // SCL:  SERCOM3/PAD[1]
  { PORTB,  1, PIO_DIGITAL,    (PIN_ATTR_NONE                                ), No_ADC_Channel, NOT_ON_PWM, NOT_ON_TIMER, EXTERNAL_INT_NONE },
  
  { PORTB,  9, PIO_ANALOG,     (PIN_ATTR_PWM|PIN_ATTR_TIMER                  ), ADC_Channel3,   PWM4_CH1,   TC4_CH1,      EXTERNAL_INT_9    },
  { PORTB,  5, PIO_ANALOG,     (PIN_ATTR_PWM|PIN_ATTR_TIMER                  ), ADC_Channel3,   PWM4_CH1,   TC4_CH1,      EXTERNAL_INT_9    },

  { PORTA,  0, PIO_DIGITAL,    (PIN_ATTR_NONE                                ), No_ADC_Channel, NOT_ON_PWM, NOT_ON_TIMER, EXTERNAL_INT_NONE },
  { PORTA,  1, PIO_DIGITAL,    (PIN_ATTR_NONE                                ), No_ADC_Channel, NOT_ON_PWM, NOT_ON_TIMER, EXTERNAL_INT_NONE },
};

extern "C" {
    unsigned int PINCOUNT_fn() {
        return (sizeof(g_APinDescription) / sizeof(g_APinDescription[0]));
    }
}

const void* g_apTCInstances[TCC_INST_NUM + TC_INST_NUM]={ TCC0, TCC1, TCC2, TC3, TC4, TC5 };

// Multi-serial objects instantiation
SERCOM sercom0(SERCOM0);
SERCOM sercom1(SERCOM1);
SERCOM sercom2(SERCOM2);
SERCOM sercom3(SERCOM3);
SERCOM sercom4(SERCOM4);
SERCOM sercom5(SERCOM5);

// Serial1
Uart Serial1(&sercom5, PIN_SERIAL1_RX, PIN_SERIAL1_TX, PAD_SERIAL1_RX, PAD_SERIAL1_TX);

void SERCOM5_Handler()
{
  Serial1.IrqHandler();
}
