BlackIoT/Martinica/(commit log)

2023-03-31 Added Schematics
    [220321_Martinica_A0_BOM.xlsx]
2023-03-31 added all files
    [arduino_zero.cfg]
